esteban3/SuperDuper411/weekly_progress_reports/CWong/CWong_WeeklyProgressReport_11-3-14.JPG

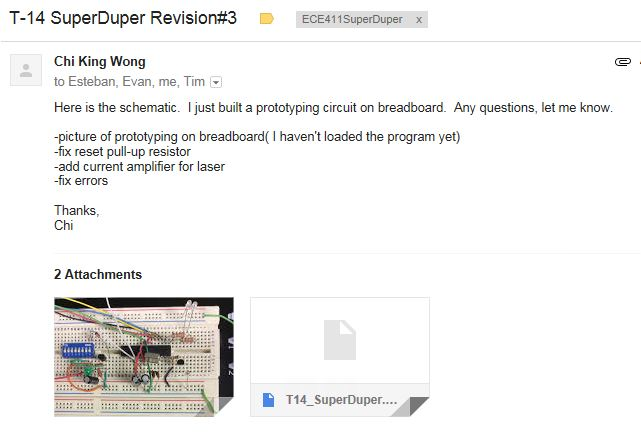
weekly_progress_reports/CWong/CWong_WeeklyProgressReport_11-3-14.JPG
