esteban3/SuperDuper411/FinalReport.pdf

# 411 Project Final Report:

## SuperDuper Cat Toy

Portland State University

Maseeh College of Engineering & Computer Science

Department of Electrical & Computer Engineering

### Authors:

Jennifer Carr

Esteban Gonzalez

Tim Gulzow

Evan Sprecher

Chi Wong

### December 11, 2014


ECE 411

Industrial Design Process

Title | PSU ECE 348L

## Contents

1 Introduction | 3
2 Design Considerations | 4
3 Product Creation | 7
4 Results | 11
5 Conclusion | 12
1900 SW 4th Ave, suite 160, Portland, OR 97201 • www.pdx.edu/power-lab/ | 1

## List of Figures

1 | Project Requirements Specifications | | 4
2 | Marketing Requirements Specifications | | 5
3 | SuperDuper Schematic | | 7
4 | SuperDuper Board Layout | | 8
5 | SuperDuper Arduino Code | | 9
6 | SuperDuper Bill of Materials | | 10
1900 SW 4th Ave, suite 160, Portland, OR 97201 • www.pdx.edu/power-lab/ | 2

## 1 Introduction

People love cats. Cat owners want their cats to be happy and healthy but often lack the free time needed to give their pets the exorcise that they need. We designed the SuperDuper Cat Toy to help alleviate this stress. With our innovative, motion sensing, laser cat toy, everyone’s favorite feline friend can play all day while their owners are free to do whatever they need to do.

The SuperDuper Cat Toy is a motion sensing, self moving laser pointer that will keep any cat busy for hours. This system comes fully contained in a hard plas-tic dome to keep all of the components safe from fuzzy paws. This device can be ether wall or ceiling mounted and can be powered with batteries or a mini-USB cable.

We at the SuperDuper Cat Toy team believe that by creating an affordable, easy to use feline entertainment device, we can exploit a fairly large market consisting of busy professionals that love their cats but don’t always have the time to give them the attention they need. Not only will this device help keep a cat happy and healthy, but it will also entertain them wile they are alone in the house keeping them from scratching furniture. The fact that this cat toy works even when no one but the cat is home, means that it is a much more versatile option than similar products that are currently on the market such as hand held lasers or floor based units that must be manually turned on and off everytime.

1900 SW 4th Ave, suite 160, Portland, OR 97201 • www.pdx.edu/power-lab/ | 3

## 2 Design Considerations

In order to create a marketable feline entertainment device we decided to aim for the following baseline specifications.

Project Specifications

- Be activated by motion
- Be powered using a 9-volt battery or mini-USB cable
- Automatically turn off to conserve power
- Control the motion of a laser

Our requirements specifications are as follows:

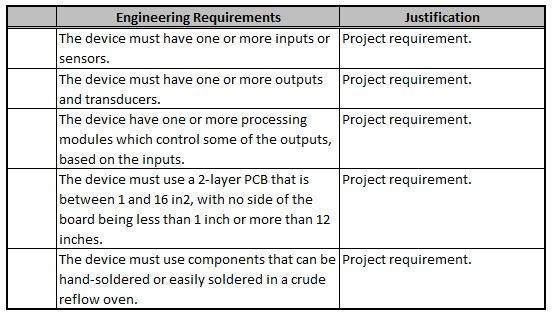
[picture p4: figure]

Figure 1: Project Requirements Specifications

1900 SW 4th Ave, suite 160, Portland, OR 97201 • www.pdx.edu/power-lab/ | 4

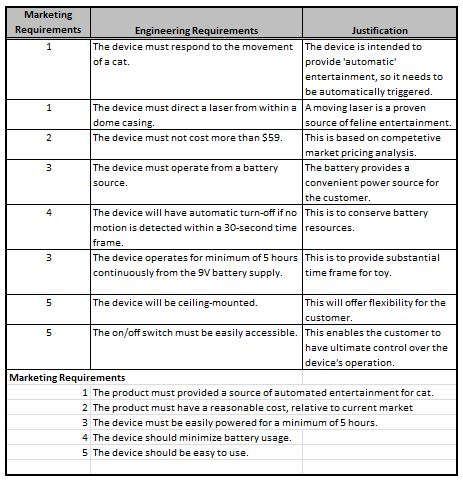
[picture p5: figure]

Figure 2: Marketing Requirements Specifications

Once we established our basic specifications, we started the design process in earnest. The following is a short breakdown of how we decided to meet the aforementioned specifications. Due to the unavailability of mass produced printed circuit boards (PCB) that fit our needs, we will design our own. The laser will be controlled using two interconnected servos. Everything will be controlled using high-level C programming of an Arduino chip. The working components will be encapsulated in a enclosure that was originally designed to house a security camera. All components will be mounted on a raised platform inside the enclosure. The battery mount will

1900 SW 4th Ave, suite 160, Portland, OR 97201 • www.pdx.edu/power-lab/ | 5

be positioned under the component mounting platform. A removable mini-USB cord will be placed on the side of the enclosure. Finally a power switch will be mounted on the exterior of the enclosure.

1900 SW 4th Ave, suite 160, Portland, OR 97201 • www.pdx.edu/power-lab/ | 6

## 3 Product Creation

The PCB for this project designed using Eagle CAD. After gathering feedback from the class instructors, teaching assistants, and running tests in Eagle CAD we made a number of adjustments to our original design. These revisions include the addition of a pull-up resistor for the reset and adjusting the dimensions off the power input line. The final design can be seen in Figures 1 and 2 below.

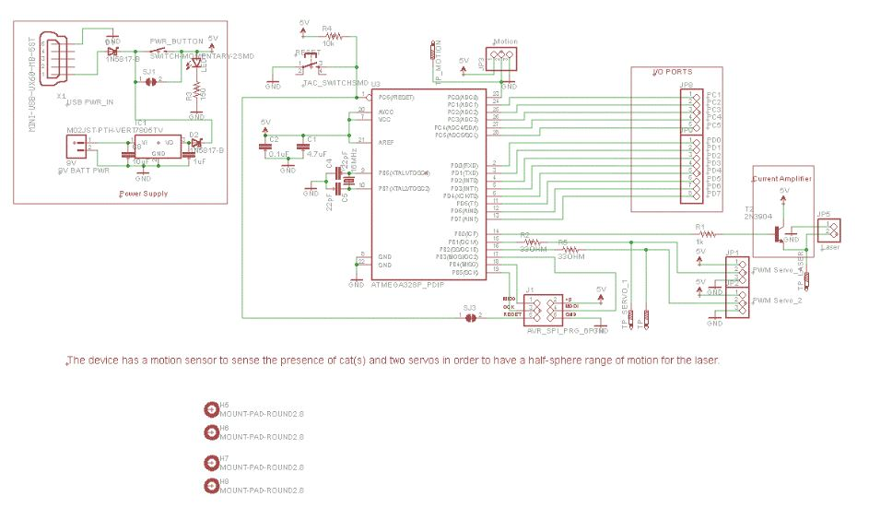
[picture p6: figure]

Figure 3: SuperDuper Schematic

1900 SW 4th Ave, suite 160, Portland, OR 97201 • www.pdx.edu/power-lab/ | 7

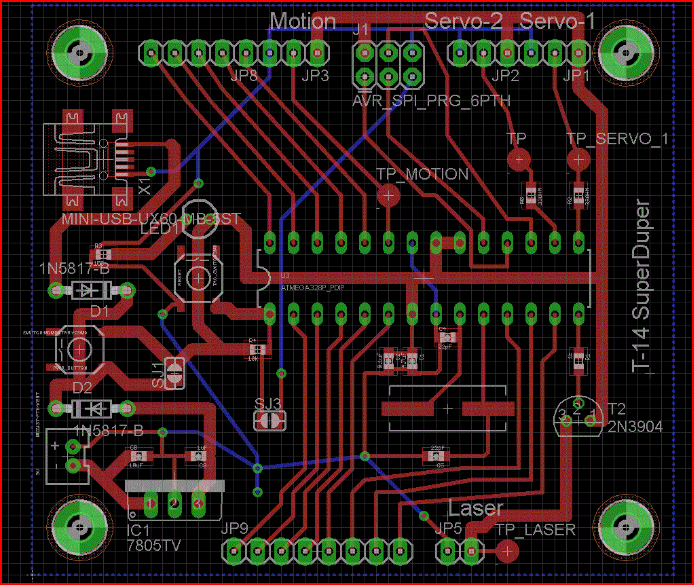
[picture p7: figure]

Figure 4: SuperDuper Board Layout

The Arduino code that was used in this project was based on open source servo controller code. Modifications where made to the code to allow it to control our servos, turn the laser on and off, and process the input from the motion sensor. We also needed to make adjustments to both the speed and range of the servo movement in order to ensure that the laser motion could be followed by a cat.

Our Arduino code is shown below:

1900 SW 4th Ave, suite 160, Portland, OR 97201 • www.pdx.edu/power-lab/ | 8

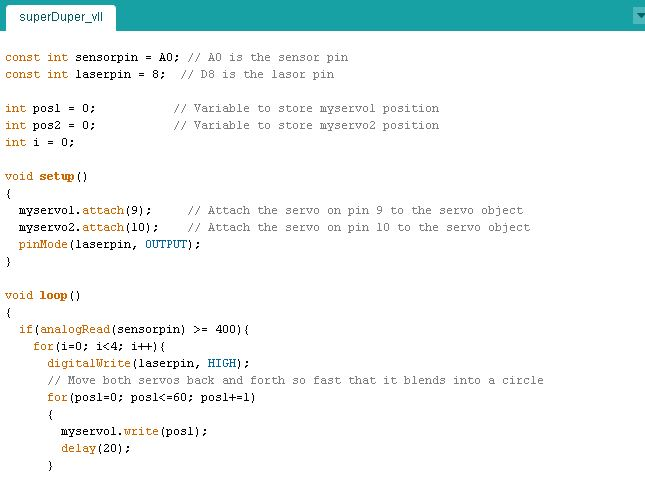
[picture p8: figure]
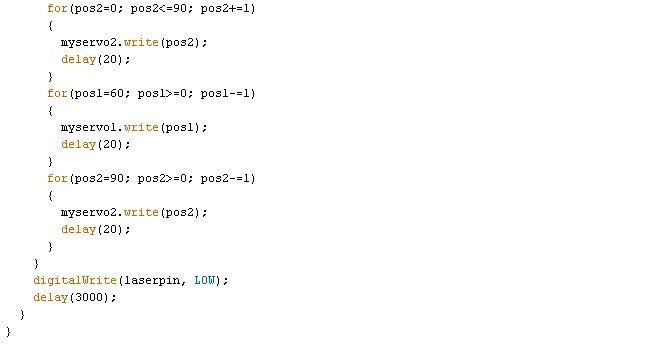
[picture p9: figure]

Figure 5: SuperDuper Arduino Code

The design and fabrication of the structural components such as the component mounting platform and the motion sensor mount where done in an ad hoc way. Wood was used as the main building material due to the ease with which it can be manipulated using hand tools. The platform was originally designed to be a four legged table like device with the legs straddling the PCB. This design had to be modified because the PCB ended up being larger than first anticipated therefore a three legged design was used. The motion sensor mount was created using pieces of

1900 SW 4th Ave, suite 160, Portland, OR 97201 • www.pdx.edu/power-lab/ | 9

wooden dowel and a cross member that was carved out of a stick. The last structural to be considered are the brackets used to hold the servos. These where created in a fabrication facility that one of our team members works at and further modified to ensure that all of the components would fit inside the enclosure.
Our Bill of Materials is shown below:

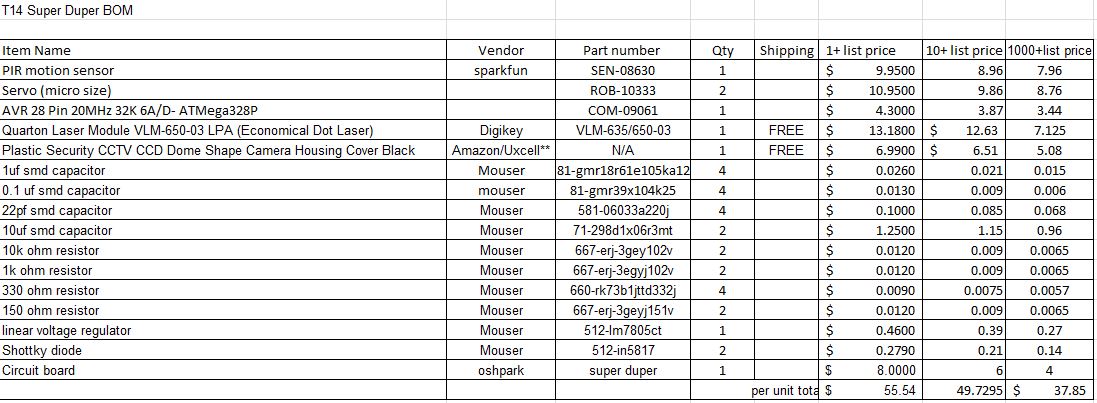
[picture p10: figure]

Figure 6: SuperDuper Bill of Materials

1900 SW 4th Ave, suite 160, Portland, OR 97201 • www.pdx.edu/power-lab/ | 10

## 4 Results

Once everything was built we began testing with the following results. While most of the project requirements where met we where unable to fit the battery holder under the component mounting platform due to lack of space, the legs needed to be shortened substantially to ensure the servos would have a full range of motion. It was also noted that when the project operated continuously for any considerable amount of time the voltage regulator would get fairly hot. This is a possible concern due to the fact that this component is in a tightly confined area surrounded by various wires and may create a fire hazard if the device runs continuously. Another issue is that even if we had been able to fit a 9 volt battery into the enclosure, the current draw of the device is high enough that the battery would only last around 1.5 hours of continuous use. Finally removing the chip in order to reprogram it was problematic because it required dis-assembly of the entire project and removing the chip from the housing on the PCB was difficult to do without binding the pins.

1900 SW 4th Ave, suite 160, Portland, OR 97201 • www.pdx.edu/power-lab/ | 11

## 5 Conclusion

Wile we where able to hit most of our stated project specifications, as the SuperDuper Cat Toy stands today it is not ready to be taken to the market. Some modifications to the current design should be implemented to ensure that it is a more viable product. For instance, a custom enclosure that will ensure that there is plenty of room for the servos and the battery could be designed. Using three AAA batteries rather than one 9 volt battery would reduce the power drawn by the electrical components by decreasing the voltage. The range of motion of the servo that holds the laser should be reduced to create a smaller path for the cats to follow. The controlling code should be modified to allow both servos to move at the same time allowing for more interesting shapes than a simple rectangle. The use of surface mounted components, a smaller SMD Arduino, and reducing the size of the PCB would cut down on parts costs as well as power consumption.

With the aforementioned modifications in place and a well designed marketing plan, the SuperDuper Cat Toy has the potential to revolutionise cat ownership across the globe. The future of feline entertainment is upon us.

1900 SW 4th Ave, suite 160, Portland, OR 97201 • www.pdx.edu/power-lab/ | 12
