esteban3/SuperDuper411/weekly_progress_reports/EGonzalez/Portland State University Mail - ECE 411 WPR Gonzalez11_21.pdf

12/11/2014 | Portland State University Mail ECE 411 WPR Gonzalez
https://mail.google.com/mail/u/0/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 | 1/1

Esteban Gonzalez <esteban3@pdx.edu>

## ECE 411 WPR Gonzalez

2 messages

Esteban Gonzalez <esteban3@pdx.edu> | Thu, Nov 20, 2014 at 11:53 PM
To: Jennifer Carr <jencarr@pdx.edu>, Timothy Gulzow <tgulzow@pdx.edu>, Chi King Wong <chiking@pdx.edu>, Evan Sprecher <sprecher@pdx.edu>

Hi All,

I still have not been able to get my stuff uploaded to github. I am still working on finalizing the BOM with part numbers and qty pricing. I did have a little glitch and the order I placed with Digikey last week did not ship due to a credit card error on my part. It would have been nice if they sent me an email or something. Anyway, rather than go through that again, I took Chi's advice and ordered the parts again through Mouser. They should be here by Tuesday at the latest, and I ordered enough parts to make 5 full boards. There is only a requirement to have one working prototype, so I will leave it up to each individual if they want to purchase a laser, motion sensor, servos and other associated stuff to make a complete project for themselves. Hope you all have a great weekend.

Esteban

Jennifer Carr <jencarr@pdx.edu> | Fri, Nov 21, 2014 at 7:53 AM
To: Esteban Gonzalez <esteban3@pdx.edu>

Thank you, Esteban! Could you send me a copy of the Mouser invoice? Thanks!
[Quoted text hidden]
