esteban3/SuperDuper411/weekly_progress_reports/EGonzalez/Portland State University Mail - T14 super duper WPR12_11.pdf

12/11/2014 | Portland State University Mail T14 super duper WPR
https://mail.google.com/mail/u/0/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 | 1/1

Esteban Gonzalez <esteban3@pdx.edu>

## T14 super duper WPR

1 message

Esteban Gonzalez <esteban3@pdx.edu> | Thu, Dec 11, 2014 at 10:19 AM
To: Jennifer Carr <jencarr@pdx.edu>, Evan Sprecher <sprecher@pdx.edu>, Timothy Gulzow <tgulzow@pdx.edu>, Chi King Wong <chiking@pdx.edu>

Hi all,

Here is my last WPR for this absolutely fantastic project and the best team ever. I have been working very hard at maintaining a positive attitude, but have been slightly less successful at reducing my sarcasm. Of well, nothing ventured nothing gained. The past week I have been working with my team mates to finalize our project and finish up the final report. I took a short video of my cat playing with a laser positioned in a similar position as our prototype. This is by far his favorite toy and the only one he does not get bored with. I worked with Tim to solve the last small details of the mechanical interactions. Jennifer used this information to modify the code to limit the sweep of the laser in order to keep it from hitting any structures in the enclosure. I woke up this morning, took a shower, shaved and got dressed. Lets rock this thing.

Esteban
