esteban3/SuperDuper411/requirements/RequirementsSpecRevised.xlsx

Sheet: MktReq
T14 - SuperDuper
Carr, Gonzalez, Gulzow, Sprecher, Wong
ECE411 - HW2
 | REQUIREMENTS DOCUMENTATION - Marketing Requirements
Marketing Requirements | Engineering Requirements | Justification
1 | The device must respond to the movement of a cat. | The device is intended to provide 'automatic' entertainment, so it needs to be automatically triggered.
1 | The device must direct a laser from within a dome casing. | A moving laser is a proven source of feline entertainment.
2 | The device must not cost more than $59. | This is based on competetive market pricing analysis.
3 | The device must operate from a battery source. | The battery provides a convenient power source for the customer.
4 | The device will have automatic turn-off if no motion is detected within a 30-second time frame. | This is to conserve battery resources.
3 | The device operates for minimum of 5 hours continuously from the 9V battery supply. | This is to provide substantial time frame for toy.
5 | The device will be ceiling-mounted. | This will offer flexibility for the customer.
5 | The on/off switch must be easily accessible. | This enables the customer to have ultimate control over the device's operation.
Marketing Requirements
1 | The product must provided a source of automated entertainment for cat.
2 | The product must have a reasonable cost, relative to current market products.
3 | The device must be easily powered for a minimum of 5 hours.
4 | The device should minimize battery usage.
5 | The device should be easy to use.

Sheet: ProjectReq
T14 - SuperDuper
Carr, Gonzalez, Gulzow, Sprecher, Wong
ECE411 - HW2
 | REQUIREMENTS DOCUMENTATION - Project Requirements
 | Engineering Requirements | Justification
 | The device must have one or more inputs or sensors. | Project requirement.
 | The device must have one or more outputs and transducers. | Project requirement.
 | The device have one or more processing modules which control some of the outputs, based on the inputs. | Project requirement.
 | The device must use a 2-layer PCB that is between 1 and 16 in2, with no side of the board being less than 1 inch or more than 12 inches. | Project requirement.
 | The device must use components that can be hand-soldered or easily soldered in a crude reflow oven. | Project requirement.

Sheet: Sheet2
Housing
Lasers
Servos
Reduce size of board & chip
