esteban3/SuperDuper411/weekly_progress_reports/EGonzalez/Portland State University Mail - T14 WPR12_3.pdf

12/11/2014 | Portland State University Mail T14 WPR
https://mail.google.com/mail/u/0/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 | 1/1

Esteban Gonzalez <esteban3@pdx.edu>

## T14 WPR

1 message

Esteban Gonzalez <esteban3@pdx.edu> | Wed, Dec 3, 2014 at 11:20 AM
To: Jennifer Carr <jencarr@pdx.edu>, Chi King Wong <chiking@pdx.edu>, Evan Sprecher <sprecher@pdx.edu>, Timothy Gulzow <tgulzow@pdx.edu>

Hi All,

It has been a while since my last confession. Please forgive me all my transgressions. Over the last couple of weeks I have worked with Tim on figuring out some of the mechanical aspects of the design. I also took a trip out to Surplus Gizmos and bought a few more parts and components to help finish things up. I have been able to upload things to Github, but am still not sure how to link them to our WIKI.I am looking forward to our presentation and getting our prototype polished up a little bit. I will continue to work on getting our documentation filled out.

Esteban
