esteban3/SuperDuper411/data_sheets_etc/Quarton Laser.JPG

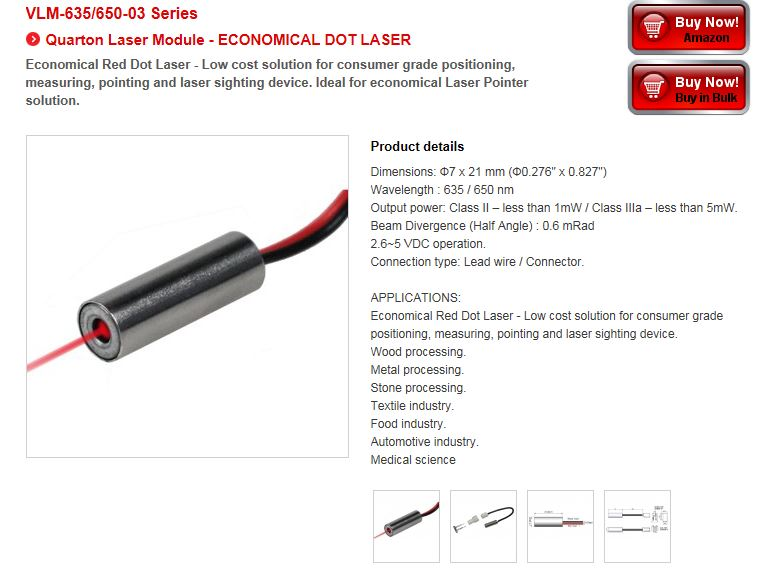
data_sheets_etc/Quarton Laser.JPG
