esteban3/SuperDuper411/data_sheets_etc/SainSmart Nano v3.JPG

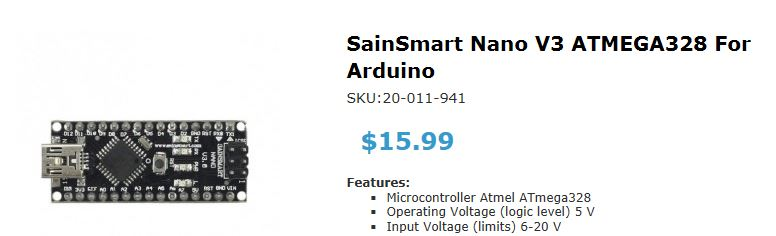
data_sheets_etc/SainSmart Nano v3.JPG
