esteban3/SuperDuper411/data_sheets_etc/Zitrades Human Sensor.JPG

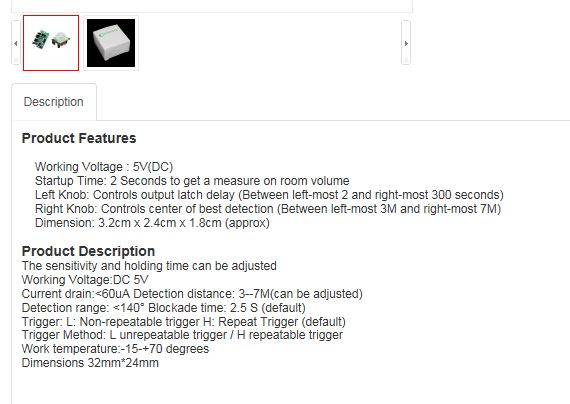
data_sheets_etc/Zitrades Human Sensor.JPG
