esteban3/SuperDuper411/images/BoardBaby.JPG

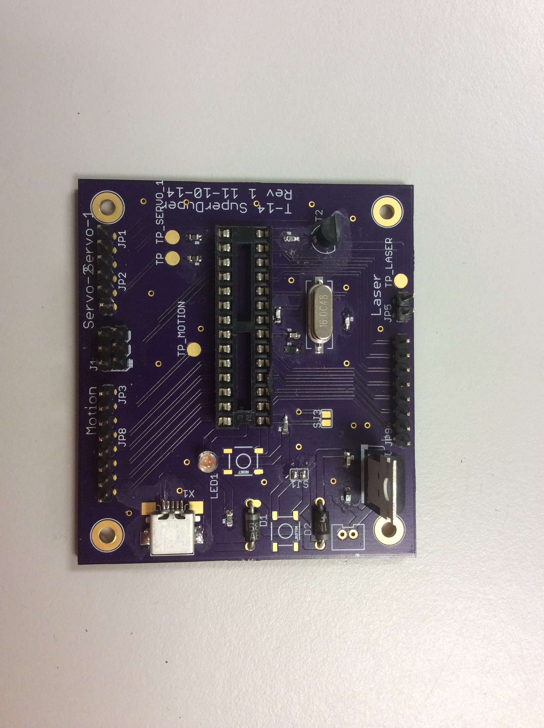
images/BoardBaby.JPG
