esteban3/SuperDuper411/images/SuperDuper.JPG

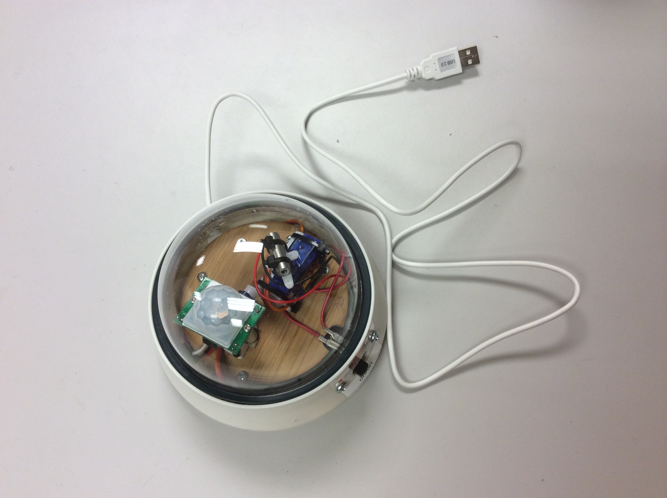
images/SuperDuper.JPG
