esteban3/SuperDuper411/images/T14PrototypeLayout_11-3-14.jpg

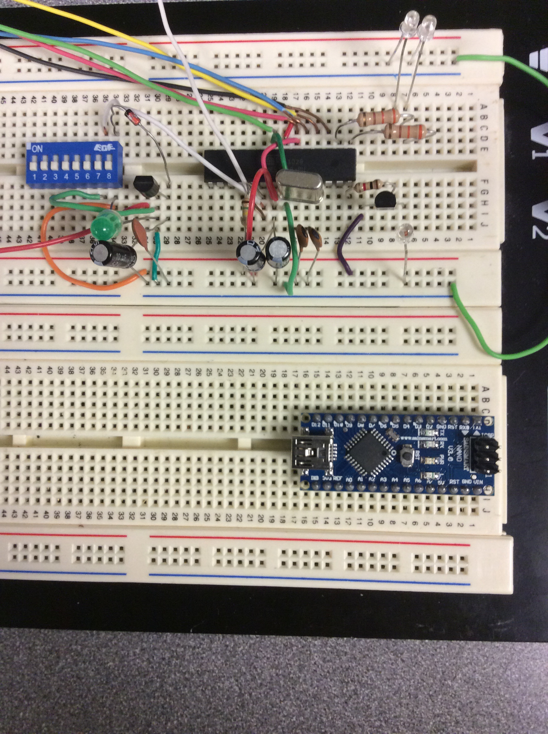
images/T14PrototypeLayout_11-3-14.jpg
