esteban3/SuperDuper411/images/TimingDiagram.jpg

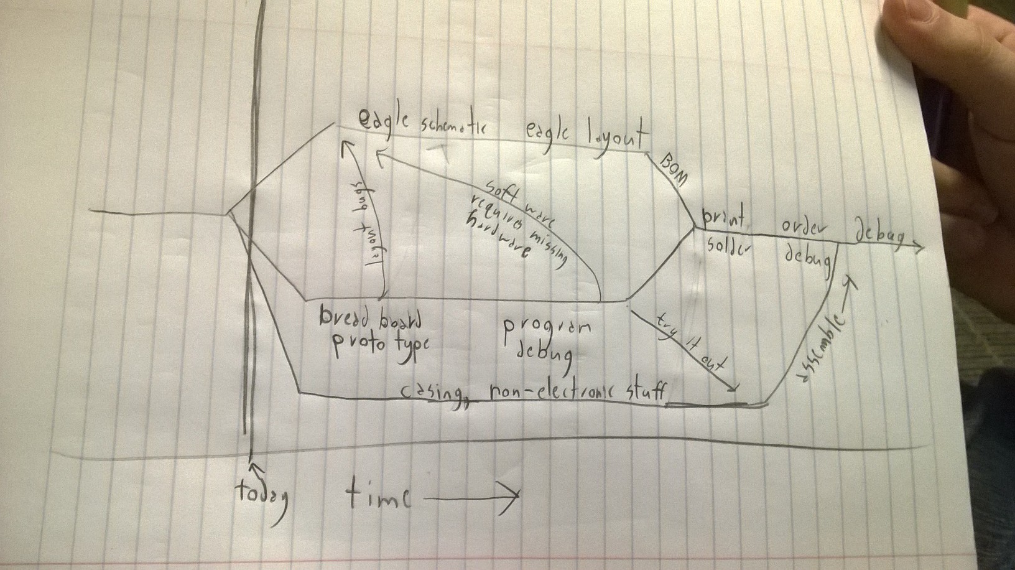
images/TimingDiagram.jpg
