esteban3/SuperDuper411/weekly_progress_reports/JCarr/JCarr_WeeklyProgressReport_11-4-14.JPG

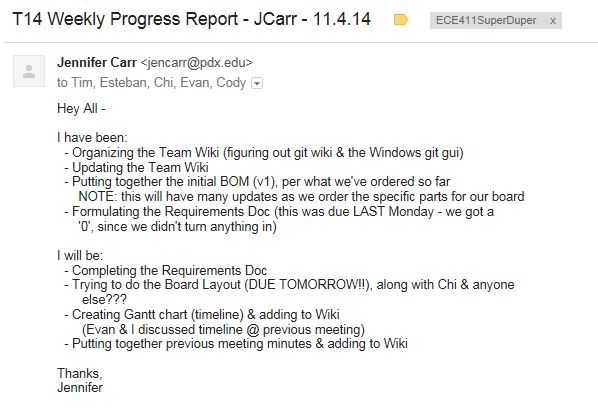
weekly_progress_reports/JCarr/JCarr_WeeklyProgressReport_11-4-14.JPG
