esteban3/SuperDuper411/weekly_progress_reports/JCarr/JCarr_WeeklyProgressReport_12-3-14.JPG

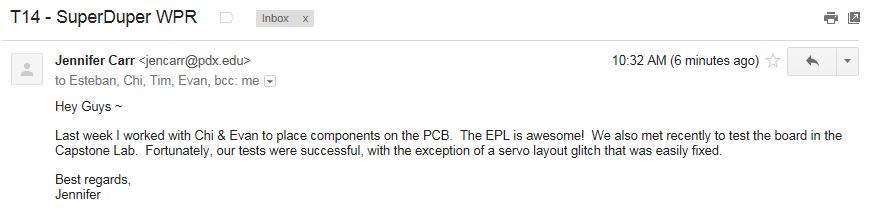
weekly_progress_reports/JCarr/JCarr_WeeklyProgressReport_12-3-14.JPG
