esteban3/SuperDuper411/weekly_progress_reports/JCarr/JCarr_WeeklyProgressReport_12-11-14.JPG

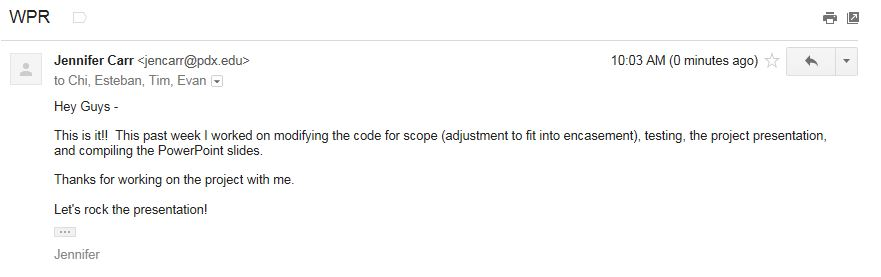
weekly_progress_reports/JCarr/JCarr_WeeklyProgressReport_12-11-14.JPG
