esteban3/SuperDuper411/weekly_progress_reports/TGulzow/TGulzow_WeeklyProgressReport_12-12-14.JPG

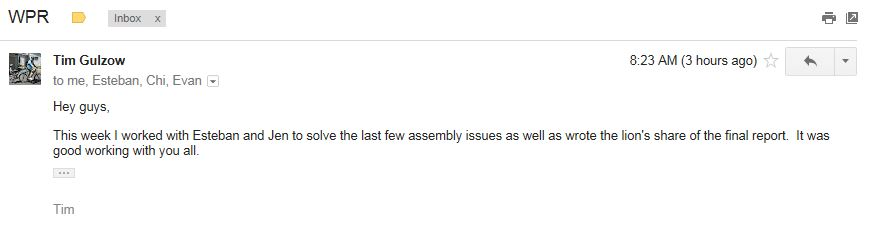
weekly_progress_reports/TGulzow/TGulzow_WeeklyProgressReport_12-12-14.JPG
