esteban3/SuperDuper411/boms/ECE 411 final BOM from Chi.docx

T-14 SuperDuper Part List

The quantity of this part list is just good for one circuit board.

Capacitor: surface mount

Package: 0603 >> Size Dimension: 0.63 x 0.31 inches

Value: 0.1uF, 1uF, 4.7uF, 10uF, 22pF, 22pF

http://www.mouser.com/Passive-Components/Capacitors/_/N-5g7r?P=1yzmou6Z1yzmou5

LED: thru hole

Size: 3 mm

DIODE: thru hole

Manufacture Part #: 1N5817

Quantity: 2

http://www.mouser.com/ProductDetail/Vishay-Semiconductors/VS-1N5817TR/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

CRYSTAL: surface mount

Value: 16 MHz

Size dimension: 10.5 mm x 4.8 mm

Manufacture: Citizen Finetech Miyota

Part #: HCM49-16.000MABJ-UT

http://www.mouser.com/ProductDetail/Citizen-Finetech-Miyota/HCM49-16000MABJ-UT/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

RESISTOR: surface mount

Package: 0603 >> Size Dimension: 0.63 x 0.31 inches

Value: 150 ohm, 10k ohm, 1 k ohm, 330 ohm, 330 ohm

http://www.mouser.com/Passive-Components/Resistors/_/N-5g9n?P=1yzmou6Z1yzmou5

VOLTAGE REGULATOR: thru hole

Part #: LM7805

http://www.mouser.com/ProductDetail/Fairchild-Semiconductor/LM7805ACT/?qs=sGAEpiMZZMtzPgOfznR9QQTeY9%252bkcWD8

TRANSISTOR: thru hole

Part #: 2N3904

http://www.mouser.com/ProductDetail/Fairchild-Semiconductor/2N3904BU/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

USB: surface mount

Connector type: USB-mini B

Gender: Female

Number of Contacts: 5

http://www.mouser.com/ProductDetail/TE-Connectivity-AMP/1734035-3/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

28 PIN IC SOCKET:

http://www.mouser.com/ProductDetail/Mill-Max/110-99-328-41-001000/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

ATMEL: ATMEGA328P-PU:

http://www.mouser.com/ProductDetail/Atmel/ATMEGA328P-PU/?qs=sGAEpiMZZMtVoztFdqDXO6rEZqxeooRg
