esteban3/SuperDuper411/boms/T14 BOM 12_10.xlsx

T14 Super Duper BOM
Item Name | Vendor | Part number | Qty | Shipping | 1+ list price | 10+ list price | 1000+list price
PIR motion sensor | sparkfun | SEN-08630 | 1 |  | $9.9500 | 8.96 | 7.96
Servo (micro size) |  | ROB-10333 | 2 |  | $10.9500 | 9.86 | 8.76
AVR 28 Pin 20MHz 32K 6A/D- ATMega328P |  | COM-09061 | 1 |  | $4.3000 | 3.87 | 3.44
Quarton Laser Module VLM-650-03 LPA (Economical Dot Laser) | Digikey | VLM-635/650-03 | 1 | FREE | $13.1800 | $12.63 | 7.125
Plastic Security CCTV CCD Dome Shape Camera Housing Cover Black | Amazon/Uxcell** | N/A | 1 | FREE | $6.9900 | $6.51 | 5.08
1uf smd capacitor | Mouser | 81-gmr18r61e105ka12 | 4 |  | $0.0260 | 0.021 | 0.015
0.1 uf smd capacitor | mouser | 81-gmr39x104k25 | 4 |  | $0.0130 | 0.009 | 0.006
22pf smd capacitor | Mouser | 581-06033a220j | 4 |  | $0.1000 | 0.085 | 0.068
10uf smd capacitor | Mouser | 71-298d1x06r3mt | 2 |  | $1.2500 | 1.15 | 0.96
10k ohm resistor | Mouser | 667-erj-3gey102v | 2 |  | $0.0120 | 0.009 | 0.0065
1k ohm resistor | Mouser | 667-erj-3egyj102v | 2 |  | $0.0120 | 0.009 | 0.0065
330 ohm resistor | Mouser | 660-rk73b1jttd332j | 4 |  | $0.0090 | 0.0075 | 0.0057
150 ohm resistor | Mouser | 667-erj-3geyj151v | 2 |  | $0.0120 | 0.009 | 0.0065
linear voltage regulator | Mouser | 512-lm7805ct | 1 |  | $0.4600 | 0.39 | 0.27
Shottky diode | Mouser | 512-in5817 | 2 |  | $0.2790 | 0.21 | 0.14
Circuit board | oshpark | super duper | 1 |  | $8.0000 | 6 | 4
 |  |  |  | per unit total | $55.54 | 49.7295 | $37.85
