esteban3/SuperDuper411/boms/T14_BOM_11_13.xlsx

 | T14 - Super Duper
 | Bill of Materials
 |  |  |  | PER ITEM | VENDOR | PER ITEM | PER UNIT
 | ITEM | VENDOR | VENDOR PART # | QUANTITY | SHIPPING | LIST PRICE | NET PRICE
1 | SainSmart Nano V3 ATMEGA328 for Arduino | SainSmart | 20-011-941 | 1 | FREE | $13.99 | $13.99
2 | VicTsing 5pcs Micro Servo Motor SG90 9G RC* | Amazon/VicDirect** | N/A | 1 | FREE | $15.99 | $15.99
3 | Zitrades HC-SR501 Human Sensor Module Pyroelectric Infrared | Amazon/Zitrades** | 108-00001-101-1-9 | 1 | FREE | $6.96 | $6.96
4 | Quarton Laser Module VLM-650-03 LPA (Economical Dot Laser) | Amazon/Quarton** | VLM-635/650-03 | 1 | FREE | $13.18 | $13.18
5 | Plastic Security CCTV CCD Dome Shape Camera Housing Cover Black | Amazon/Uxcell** | N/A | 1 | FREE | $11.78 | $11.78
6
7
8
9
10
 |  |  | SHIPPING ESTIMATE |  | FREE |  | $0.00
 | TOTAL |  |  |  |  |  | $61.90
 | NOTES:
 | *Item price is for 5 servos - only pkg sold. Unit only requires 2 servos each.
 | **Vendor primarily sells through Amazon
 | DATE & VERSION:
 | 11/3/14 - v11.01
 | Item Name | Vendor | Part number | Qty | Shipping | 1+ list price | 10+ list price | 100+list price | net price
 | PIR motion sensor | sparkfun | SEN-08630 | 4 |  | $9.95 | 8.96 | 7.96
 | Servo (micro size) |  | ROB-10333 | 8 |  | $10.95 | 9.86 | 8.76
 | AVR 28 Pin 20MHz 32K 6A/D- ATMega328P |  | COM-09061 | 4 |  | $4.30 | 3.87 | 3.44
