esteban3/SuperDuper411/(list of files, cad)

Other CAD files:
encasement_design/Platform.dwg
