esteban3/SuperDuper411/testing/TestCase1.xlsx

T14 - SuperDuper
 | Carr, Gonzalez, Gulzow, Sprecher, Wong
 | ECE411 - HW6
 | 2014-11-24
TEST INFORMATION
 | Test Writer: | Esteban Gonzalez
 | Test Case Name: | Low power mode without motion |  |  |  | Test ID #: | 1
 | Description: | After 30 seconds with no motion detected, turn off and put in sleep mode |  |  |  | Type: | □ black box □ white box
TESTER INFORMATION
 | Name of Tester: |  |  |  |  | Date:
 | Hardware Version: |  |  |  |  | Time:
 | Setup: | With power applied to unit, activate system with motion trigger. Observe laser and servos activate.
Step | Action | Expected Result | Pass | Fail | N/A | Comments
1 | Wait 30 seconds | Laser and servos turn off
2 | Monitor detector output | All low output, except for "still operating" high output
3 | Monitor power draw from PS in "off" | Power draw should be below 5mA
 | Overall Test Result:
