esteban3/SuperDuper411/testing/TestCase2.xlsx

T14 - SuperDuper
 | Carr, Gonzalez, Gulzow, Sprecher, Wong
 | ECE411 - HW6
 | 2014-11-24
TEST INFORMATION
 | Test Writer: | Evan Sprecher
 | Test Case Name: | Prototype Software Test |  |  |  | Test ID #: | 2
 | Description: | Test the code on the breadboard prototype |  |  |  | Type: | □ black box □ white box
TESTER INFORMATION
 | Name of Tester: |  |  |  |  | Date:
 | Hardware Version: |  |  |  |  | Time:
 | Setup: | Set up parts on breadboard per schematic
Step | Action | Expected Result | Pass | Fail | N/A | Comments
1 | Wave hand near motion sensor | Servo loop activates and laser blinks
2 | Wave hand near motion sensor; wait 31 seconds | Servos and laser turns off
 | Overall Test Result:
