esteban3/SuperDuper411/testing/TestCase3.xlsx

T14 - SuperDuper
 | Carr, Gonzalez, Gulzow, Sprecher, Wong
 | ECE411 - HW6
 | 2014-11-24
TEST INFORMATION
 | Test Writer: | Tim Gulzow
 | Test Case Name: | Mechanical Component Clearance |  |  |  | Test ID #: | 3
 | Description: | Verify that mechanical components can move through entire range of motion inside housing |  |  |  | Type: | □ black box □ white box
TESTER INFORMATION
 | Name of Tester: |  |  |  |  | Date:
 | Hardware Version: |  |  |  |  | Time:
 | Setup: | Set base in housing and place components where they need to be
Step | Action | Expected Result | Pass | Fail | N/A | Comments
1 | Rotate Servo 1 | Clear housing and sensor
2 | Rotate Servo 2 | Clear housing and sensor
3
 | Overall Test Result:
