esteban3/SuperDuper411/testing/TestCase4.xlsx

T14 - SuperDuper
 | Carr, Gonzalez, Gulzow, Sprecher, Wong
 | HW #6
 | 2014-11-24
TEST INFORMATION
 | Test Writer: | Esteban Gonzalez
 | Test Case Name: | Power Supply Test |  |  |  | Test ID #: | 4
 | Description: | Test 5V output from power supply When hooked up to 9V and Micro USB |  |  |  | Type: | □ black box □ white box
TESTER INFORMATION
 | Name of Tester: |  |  |  |  | Date:
 | Hardware Version: |  |  |  |  | Time:
 | Setup: | Connect system to 9V or micro USB
Step | Action | Expected Result | Pass | Fail | N/A | Comments
1 | 9V supply | 5V out from power supply
2 | Micro USB | 5V out from power supply
3
 | Overall Test Result:
