esteban3/SuperDuper411/testing/TestCaseTemplate.xlsx

T14 - SuperDuper
 | Carr, Gonzalez, Gulzow, Sprecher, Wong
 | HW #6
 | 2014-11-24
TEST INFORMATION
 | Test Writer:
 | Test Case Name: |  |  |  |  | Test ID #:
 | Description: |  |  |  |  | Type: | □ black box □ white box
TESTER INFORMATION
 | Name of Tester: |  |  |  |  | Date:
 | Hardware Version: |  |  |  |  | Time:
 | Setup:
Step | Action | Expected Result | Pass | Fail | N/A | Comments
1
2
3
 | Overall Test Result:
