esteban3/SuperDuper411/schematics/T14_SuperDuper_V_005.brd

## EAGLE design schematics/T14_SuperDuper_V_005.brd (2014-11-11, an earlier design)

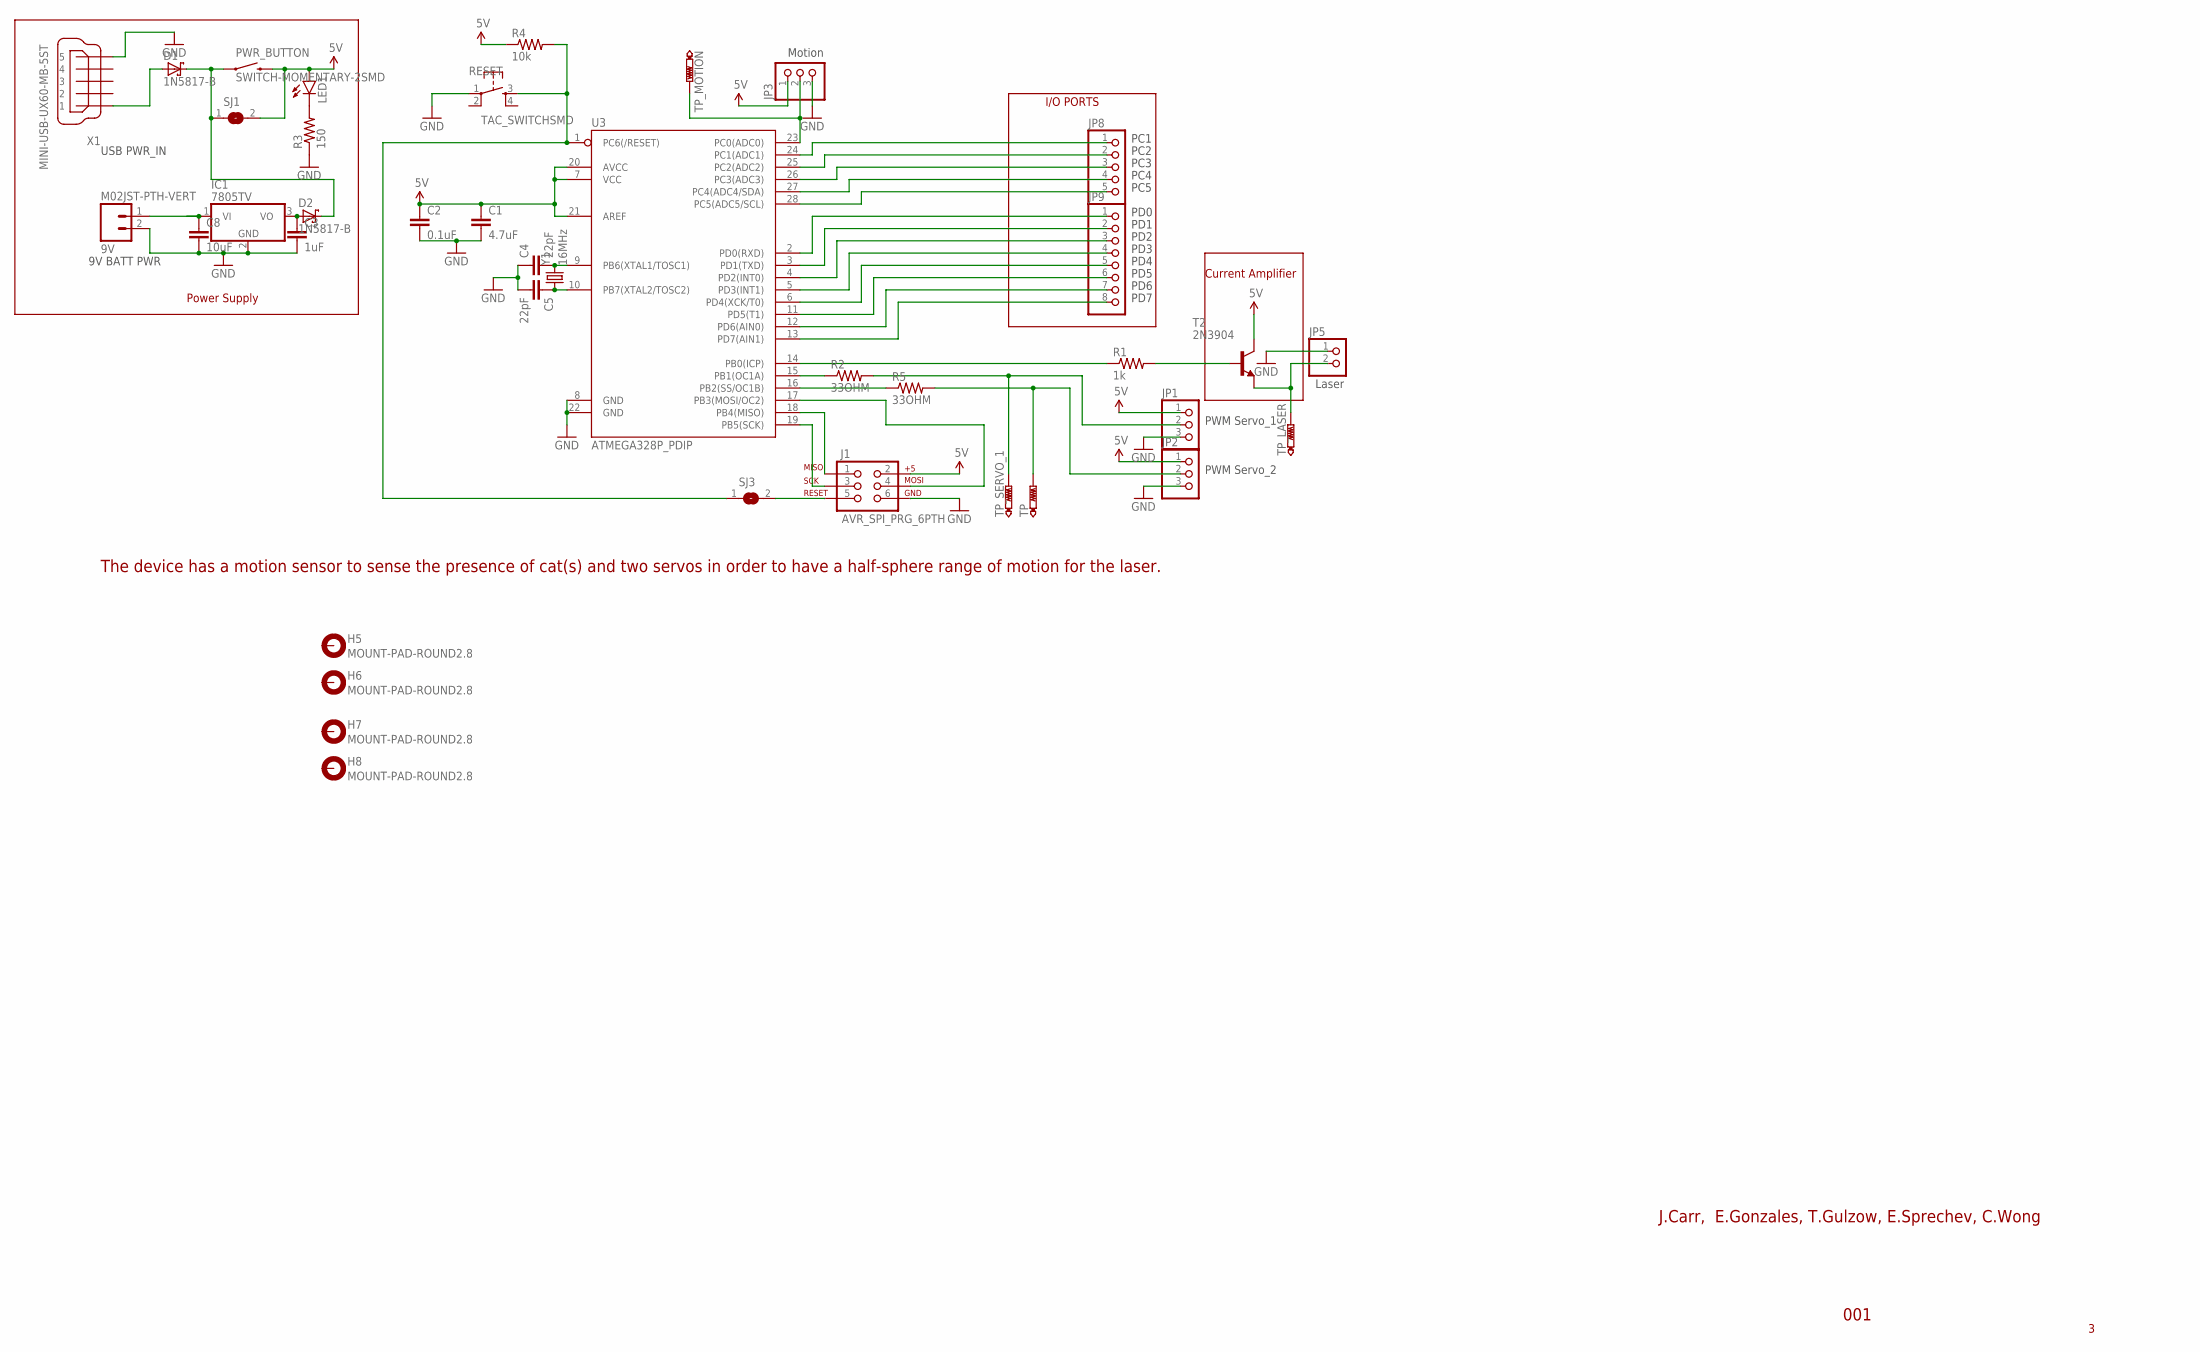
[picture p29: schematic T14_SuperDuper_V_005.sch]

Parts:
9V: M02JST-PTH-VERT; JST-2-PTH-VERT
C1: 4.7uF; 0603-CAP
C2: 0.1uF; 0603-CAP
C3: 1uF; 0603-CAP
C4, C5: 22pF; 0603-CAP
C8: 10uF; 0603-CAP
D1, D2: 1N5817-B; DO41-7.6
H5, H6, H7, H8: MOUNT-PAD-ROUND2.8; 2,8-PAD
IC1: 7805TV; TO220V
J1: AVR_SPI_PRG_6PTH; 2X3
JP1, JP2, JP3: PINHD-1X3; 1X03
JP5: PINHD-1X2; 1X02
JP8: PINHD-1X5; 1X05
JP9: PINHD-1X8; 1X08
LED1: LED-3MM-NO_SILK; LED3MM-NS
PWR_BUTTON: SWITCH-MOMENTARY-2SMD; TACTILE-SWITCH-SMD
R1: 1k; 0603
R2, R5: 33OHM; 0603
R3: 150; 0603
R4: 10k; 0603
RESET: TAC_SWITCHSMD; TACTILE-SWITCH-SMD
SJ1, SJ3: SJ
T2: 2N3904; TO92
TP: PTR1B2,54; B2,54
TP_LASER: PTR1B2,54; B2,54
TP_MOTION: PTR1B2,54; B2,54
TP_SERVO_1: PTR1B2,54; B2,54
U3: ATMEGA328P_PDIP; DIL28-3
X1: MINI-USB-UX60-MB-5ST; UX60-MB-5ST
Y1: 16MHz; CRYSTAL-SMD-10.5X4.8-2PIN

Connections:
5V: C1.1, C2.1, J1.2, JP1.1, JP2.1, JP3.1, LED1.A, PWR_BUTTON.3 (2), R4.1, SJ1.2, T2.1 (C), U3.7 (VCC), U3.20 (AVCC), U3.21 (AREF)
GND: 9V.2, C1.2, C2.2, C3.2, C4.1, C5.2, C8.2, IC1.2 (GND), J1.6, JP1.3, JP2.3, JP3.3, JP5.1, R3.1, RESET.1, U3.8 (GND), U3.22 (GND), X1.5
unnamed: D1.A, X1.1
unnamed: R2.1, U3.15 (PB1(OC1A))
unnamed: R1.2, T2.2 (B)
unnamed: JP1.2, R2.2, TP_SERVO_1.TP
unnamed: C5.1, U3.10 (PB7(XTAL2/TOSC2)), Y1.P$1 (1)
unnamed: R5.1, U3.16 (PB2(SS/OC1B))
unnamed: JP2.2, R5.2, TP.TP
unnamed: 9V.1, C8.1, IC1.1 (VI)
unnamed: R1.1, U3.14 (PB0(ICP))
unnamed: C3.1, D2.A, IC1.3 (VO)
unnamed: J1.4, U3.17 (PB3(MOSI/OC2))
unnamed: J1.1, U3.18 (PB4(MISO))
unnamed: J1.3, U3.19 (PB5(SCK))
unnamed: R4.2, RESET.3, SJ3.1, U3.1 (PC6(/RESET))
unnamed: JP3.2, TP_MOTION.TP, U3.23 (PC0(ADC0))
unnamed: C4.2, U3.9 (PB6(XTAL1/TOSC1)), Y1.P$2 (2)
unnamed: JP8.5, U3.28 (PC5(ADC5/SCL))
unnamed: JP8.4, U3.27 (PC4(ADC4/SDA))
unnamed: JP8.3, U3.26 (PC3(ADC3))
unnamed: JP8.2, U3.25 (PC2(ADC2))
unnamed: JP8.1, U3.24 (PC1(ADC1))
unnamed: JP9.1, U3.2 (PD0(RXD))
unnamed: JP9.2, U3.3 (PD1(TXD))
unnamed: JP9.3, U3.4 (PD2(INT0))
unnamed: JP9.4, U3.5 (PD3(INT1))
unnamed: JP9.5, U3.6 (PD4(XCK/T0))
unnamed: JP9.6, U3.11 (PD5(T1))
unnamed: JP9.7, U3.12 (PD6(AIN0))
unnamed: JP9.8, U3.13 (PD7(AIN1))
unnamed: JP5.2, T2.3 (E), TP_LASER.TP
unnamed: D1.C, D2.C, PWR_BUTTON.1, SJ1.1
unnamed: J1.5, SJ3.2
unnamed: LED1.K (C), R3.2

Notes on the sheet:
Laser
PWM Servo_1
PWM Servo_2
Motion
9V BATT PWR
USB PWR_IN
J.Carr, E.Gonzales, T.Gulzow, E.Sprechev, C.Wong
001
Power Supply
PC1
PC2
PC3
PC4
PC5
PD0
PD1
PD2
PD3
PD4
PD5
PD6
PD7
I/O PORTS
The device has a motion sensor to sense the presence of cat(s) and two servos in order to have a half-sphere range of motion for the laser.
Current Amplifier

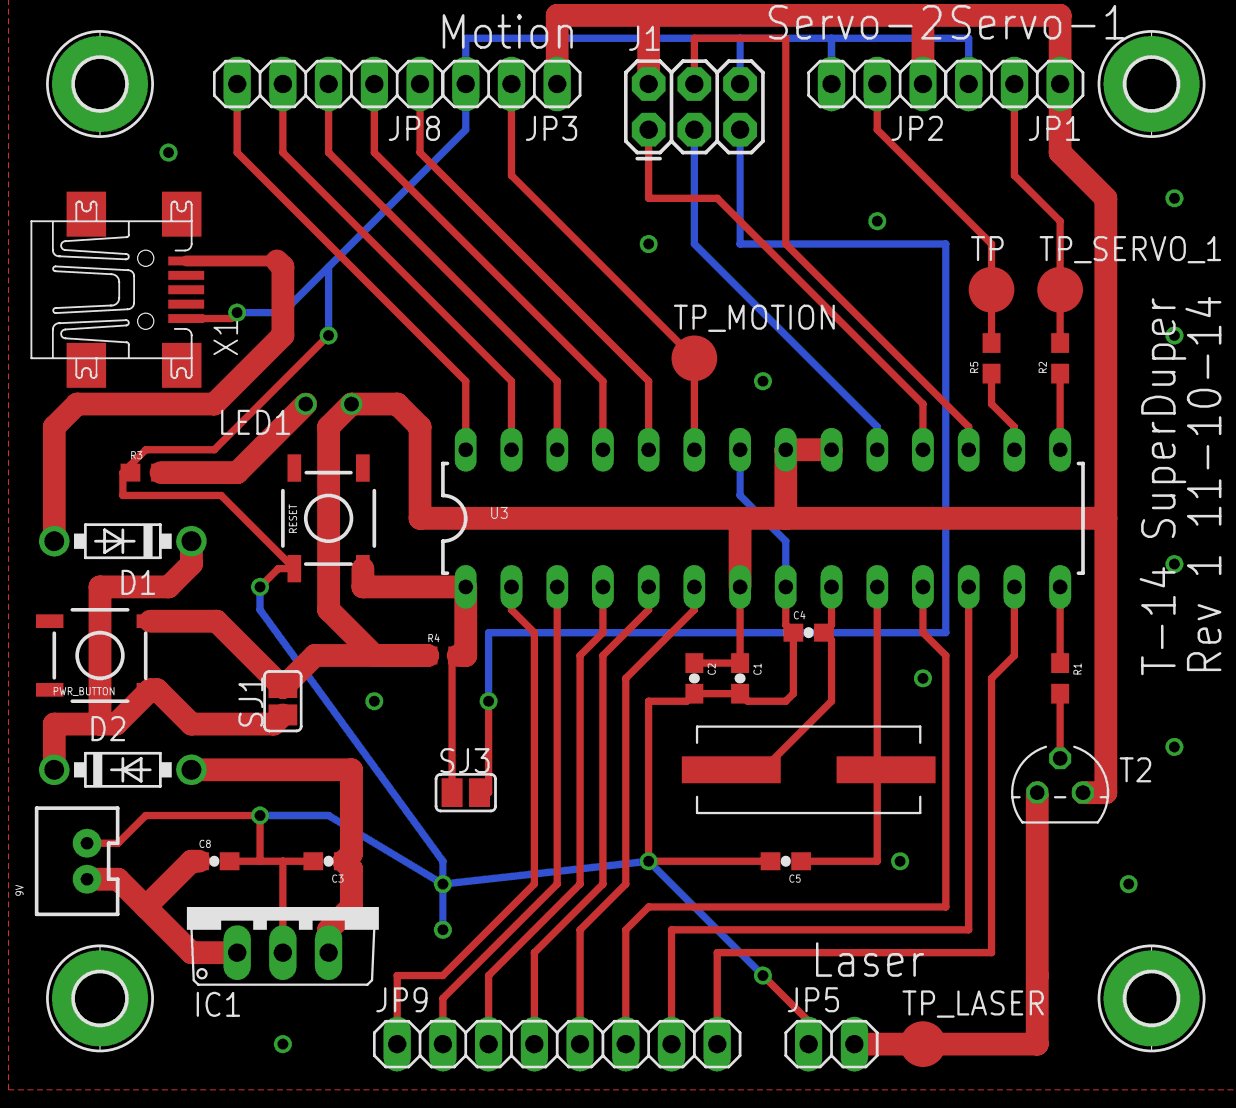
[picture p30: board T14_SuperDuper_V_005.brd from above]

Board: 2 copper layers, 39 parts (0 on the bottom side), 35 nets.
