esteban3/SuperDuper411/(commit log)

2014-10-29 T14_SuperDuperPrelimSchematic
    Preliminary Schematic
    [SuperDuperServoController.sch]
2014-10-30 Revised schematic
    Revised for proper layering, adding frame, correcting placement of
    bypass caps
    [T14_SuperDuperRev1.sch]
2014-10-30 Added power button & jumpers on board schematic
    [T14_SuperDuperRev2.sch]
2014-11-03 Added Schematics folder
    [SuperDuperServoController.sch, T14_SuperDuperRev1.sch, T14_SuperDuperRev2.sch]
2014-11-03 Adding bom
    [BOM1.xlsx]
2014-11-04 Updated schematic per Andrew Greenberg's recommendations
    [T14_SuperDuperRev3.sch]
2014-11-04 Bill of Materials
    [BOM1.xlsx]
2014-11-04 Revert "Updated schematic per Andrew Greenberg's recommendations"
    This reverts commit 7f5d9ebcb568cb28b67e02d461c7676f40850b36.
    [T14_SuperDuperRev3.sch]
2014-11-04 Updated schematic
    Updated schematic per Andrew Greenberg's recommendations of 11-3-14
    [T14_SuperDuperRev3.sch]
2014-11-04 T14_PrototypeLayout
    Prototype Layout on Breadboard
2014-11-04 Trying to consolidate schematics folder
    [SuperDuperServoController.sch, T14_SuperDuperRev1.sch, T14_SuperDuperRev2.sch]
2014-11-04 Created Project Schedule
    [ProjectSchedule.xlsx]
2014-11-05 Code for rotating laser
2014-11-05 Prelim Board Layout
    [T14_SuperDuperBoardLayoutV01.brd]
2014-11-05 Schematic corresponding to prelim board layout
    [T14_SuperDuperRev4V01.sch]
2014-11-06 Renamed schematic to match board layout
    [T14_SuperDuperV01.sch]
2014-11-06 Renamed board layout to match schematic
    [T14_SuperDuperV01.brd]
2014-11-06 Updated schematic & board layout
    [T14_SuperDuper_V_002.brd, T14_SuperDuper_V_002.sch]
2014-11-11 Uploaded updated schematics & board layouts
    [T14_SuperDuper_V_004.brd, T14_SuperDuper_V_004.sch, T14_SuperDuper_V_005.brd, T14_SuperDuper_V_005.sch, T14_SuperDuper_V_006.brd, T14_SuperDuper_V_006.sch]
2014-11-14 code takes sensor input from a random pin now.
    TODO: MAKE SURE THAT THE PIN GETS CHANGED TO THE MOTION DETECTOR PIN.
2014-11-14 Autocad drawing of platform design w/in housing
    [Platform.dwg]
2014-11-14 Recreated folder for encasement
    [Platform.dwg]
2014-11-18 Update to the code
    All is working on our current prototype, but we need to test the code on hardware that has the correct clock frequency.
    [superduper.ino]
2014-11-23 Uploaded template for test cases
    [TestCaseTemplate.xlsx]
2014-11-24 Update BOM and Specs
    include datasheets and order info
    [T14_BOM_11_13.xlsx]
2014-11-24 Test documents
    new test plan documents
    [TestCase_5V.xlsx]
2014-11-24 Uploaded Requirements Spec
    [RequirementsSpec.xlsx]
2014-11-24 Uploaded Test Plan & Test Cases
    [TestCase1.xlsx, TestCase2.xlsx, TestCase3.xlsx, TestCase4.xlsx]
2014-12-03 Hopefully the final update to the code
    Laser pin turns off when the servers turn off. Servos now run slower, and have a 3 second cooldown after being triggered.
2014-12-11 PowerPoint Presentation
2014-12-11 Updated Requirements Doc
    [RequirementsSpecRevised.xlsx]
2014-12-11 WPR update
    the last couple of weeks
    [T14 BOM 12_10.xlsx]
2014-12-11 Updated BOM
    [T14 BOM 12_10.xlsx]
